thilaksaiK/Automatic_Hydroponics_V2/README.md

Automatic_Hydroponics_V2
==========================
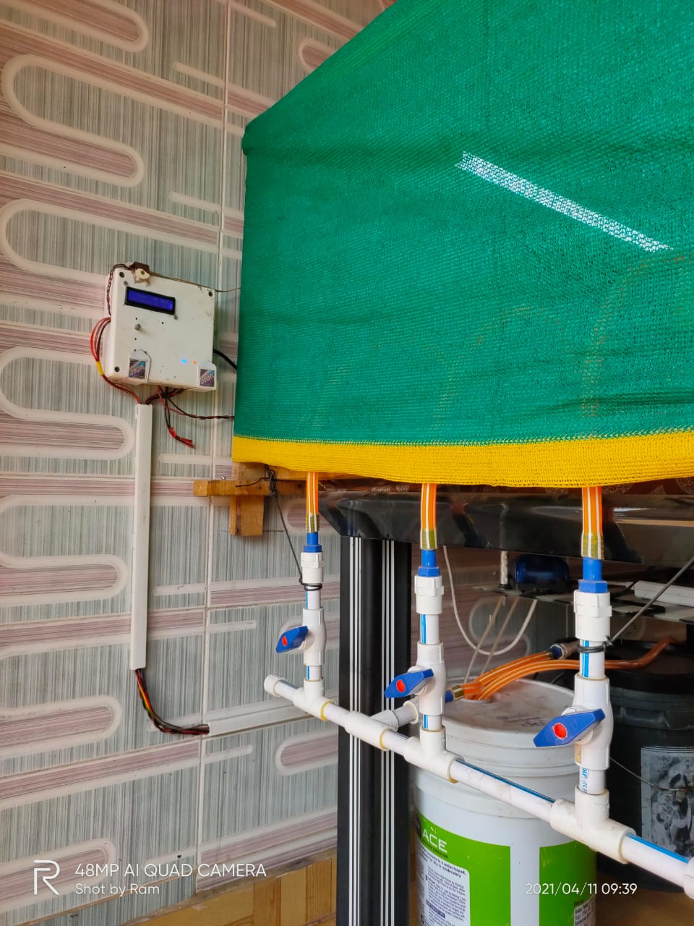
[picture p1: Images/Mounted_Setup.jpeg]
The setup

# The schematic diagram
The Schematic and PCB designs are made using KiCAD. Find the files here: [KiCad_PCB_design](PCB_designes/KiCad_PCB_design/)
## The Schematic Diagram of Master board
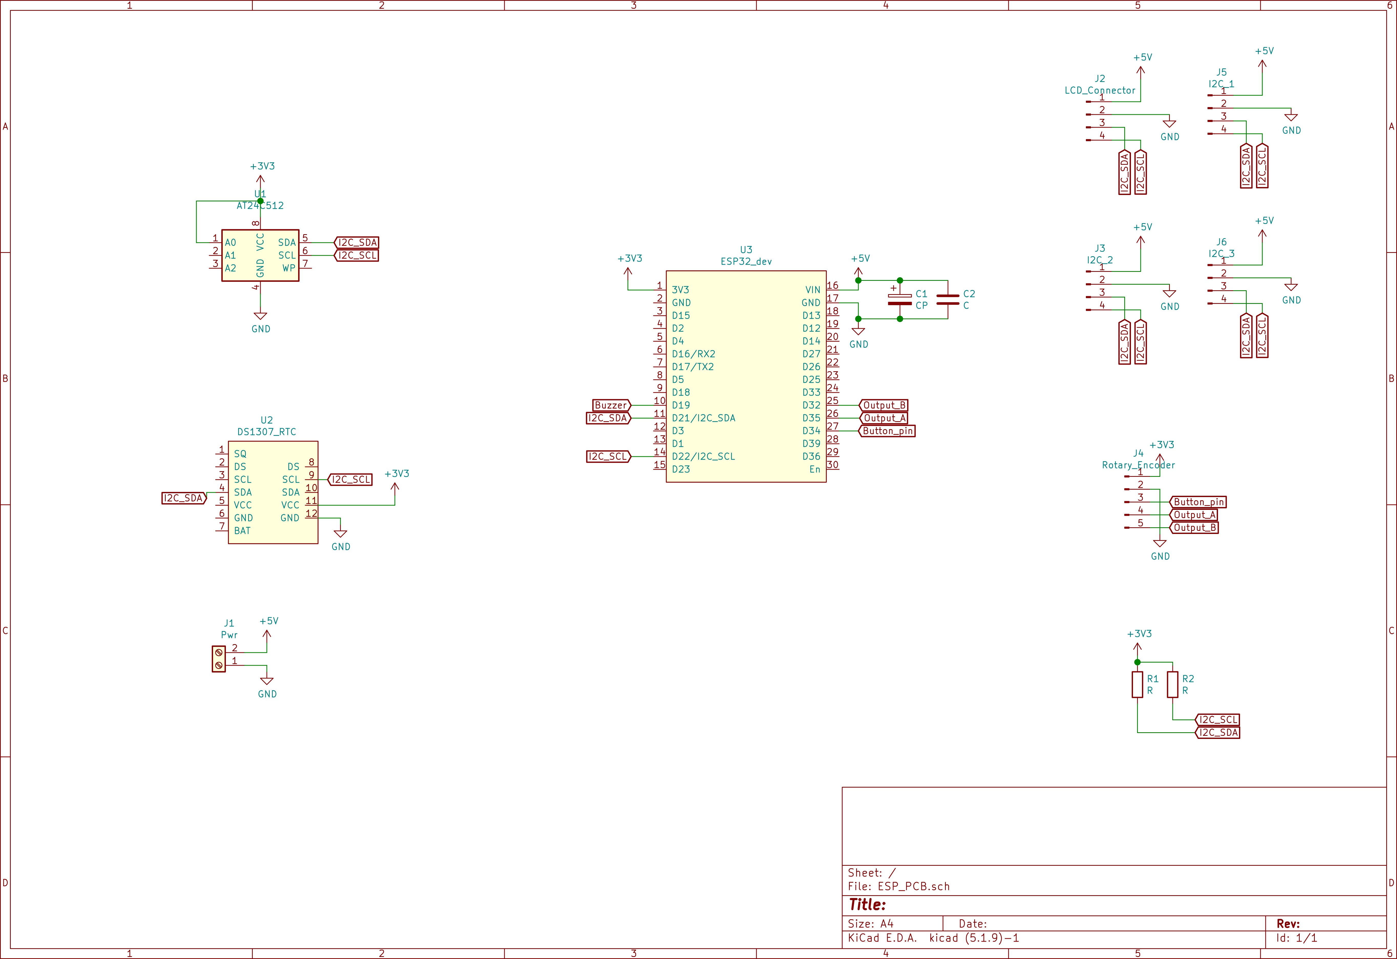
[picture p2: Images/ESP_PCB.jpg]

* The Master board has an ESP32, DS1307 RTC clock, AT24C512 EEPROM and an I2C LCD display.
* The Master board has a JST connecter port to connect to slave board. 

## The Schematic of Slave Board
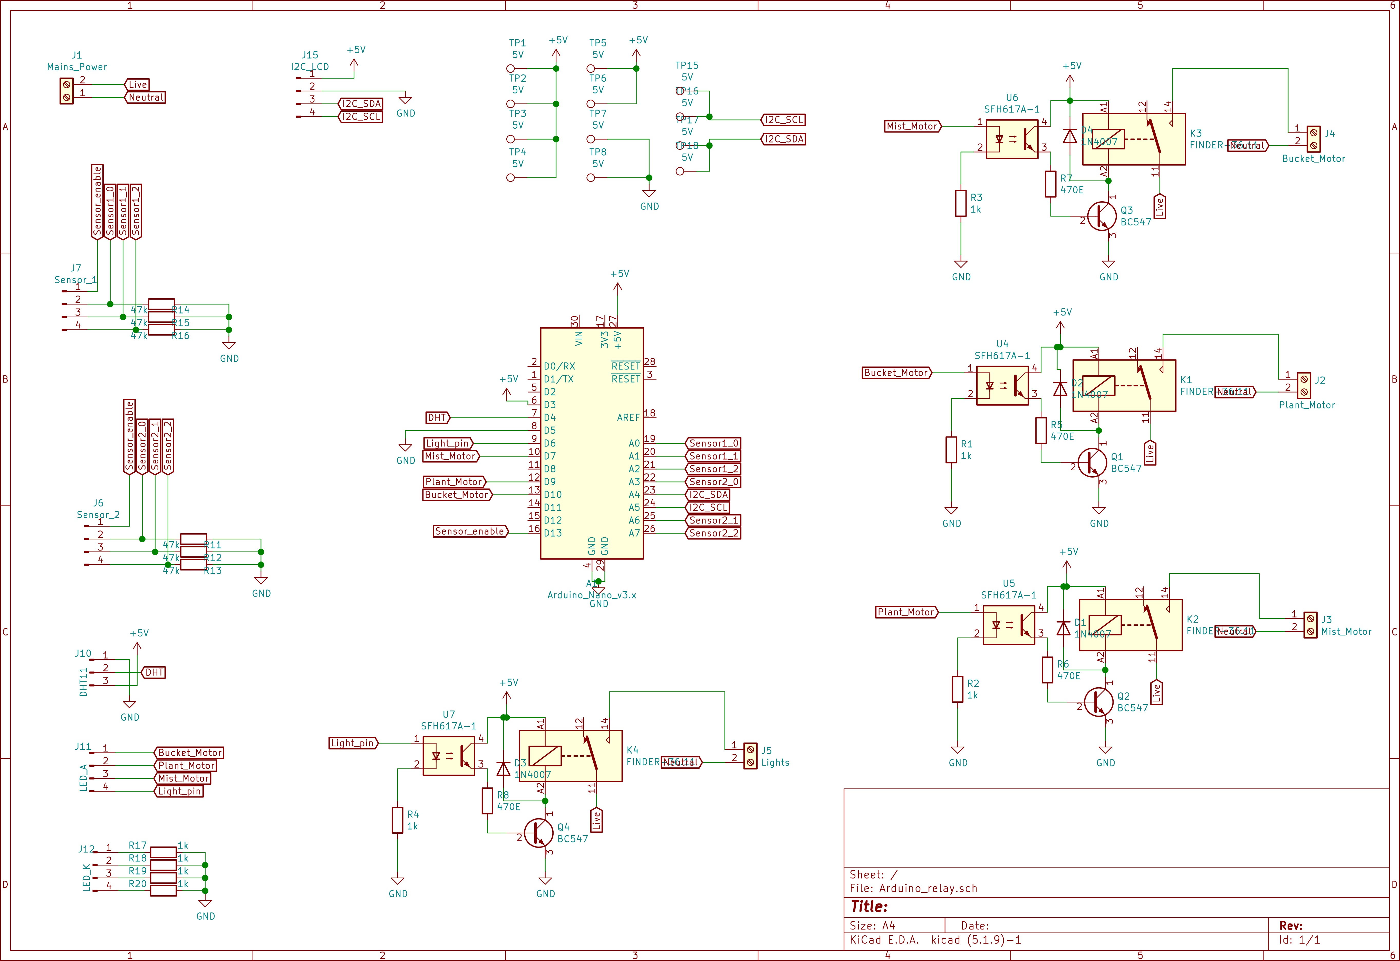
[picture p3: Images/Arduino_relay.jpg]

* The slave board has an Arduino Nano, DHT11 sensor, 4 relays. 
* The master board and slave board are connected with I2C bus.

# PCB Layout
## The PCB Layout of Master board
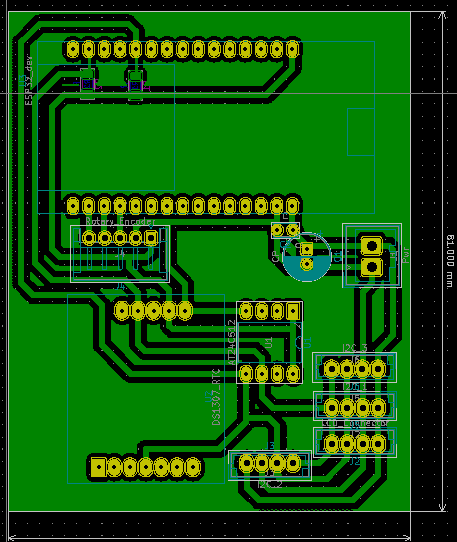
[picture p4: Images/ESP_PCB.png]
Setup_pic.jpg)

## The PCB Layout of Master board
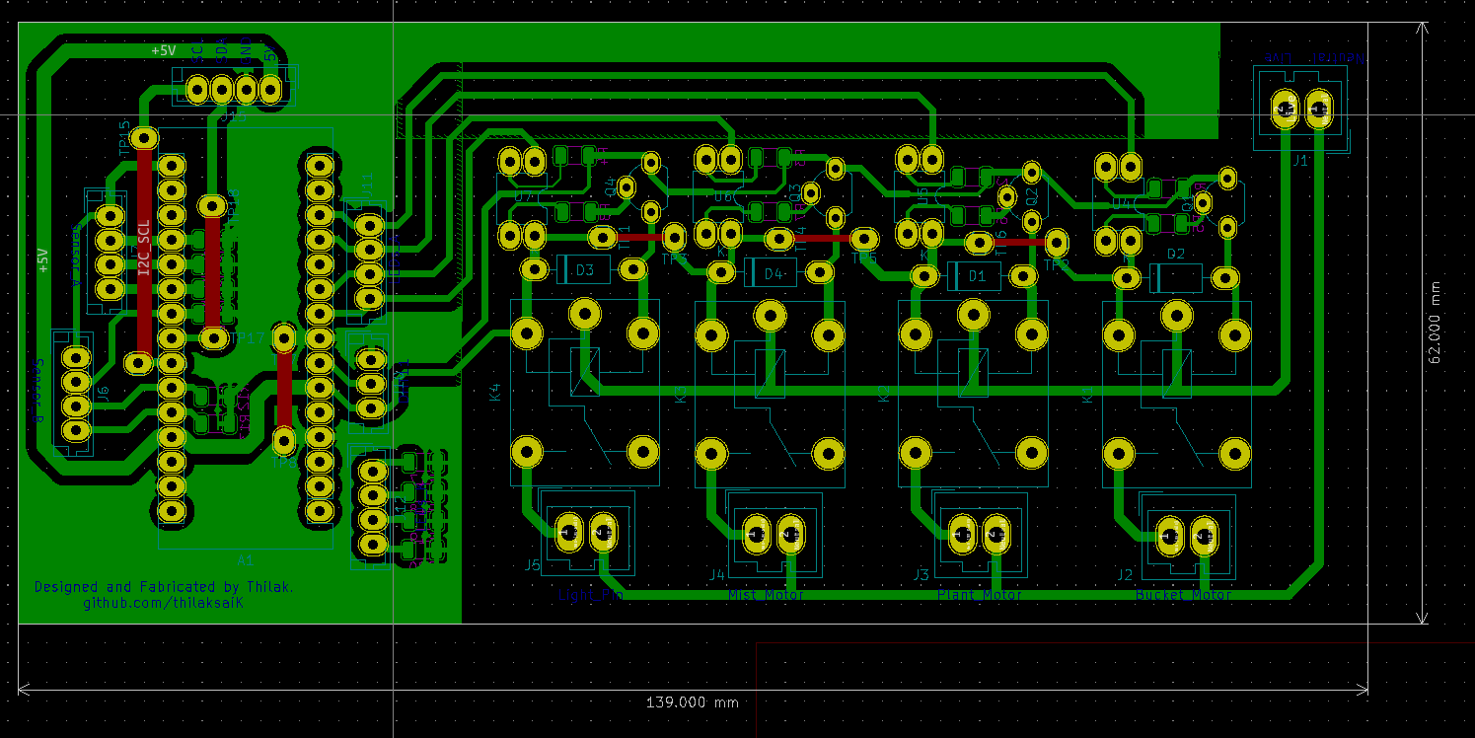
[picture p5: Images/Slave_PCB.png]


# Building the Hardware
## Master board
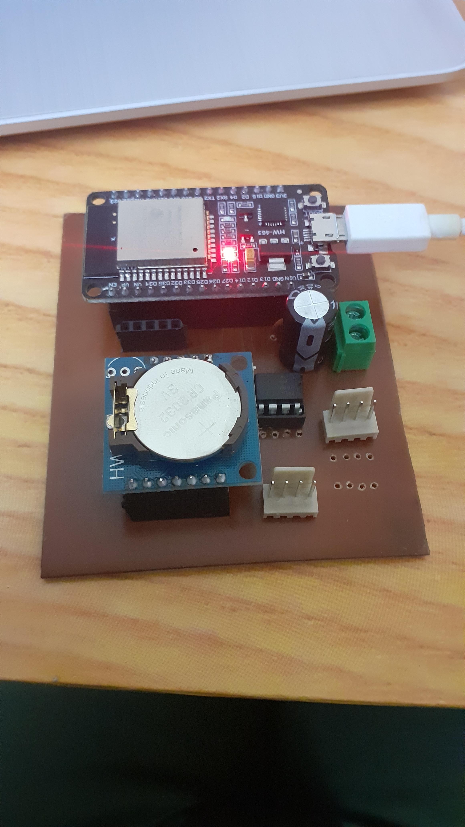
[picture p6: Images/ESP_PCB_pic.jpg]


## Total Setup Overview
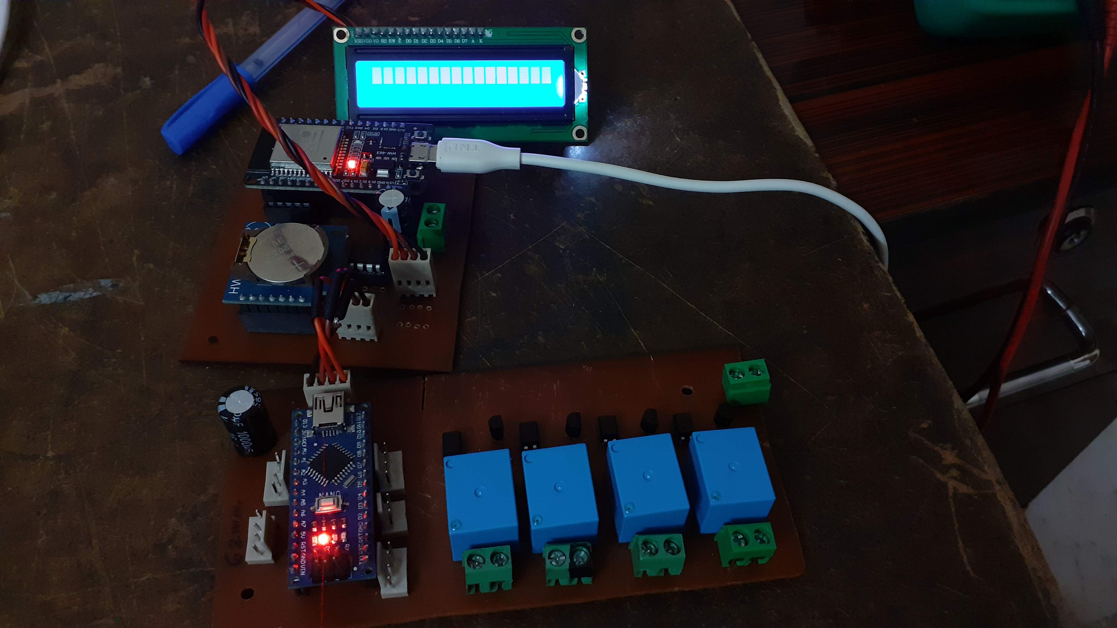
[picture p7: Images/Setup_pic.jpg]


>Find more pictures in [Images](Images) folder
## Using `I2CSB` library.

This Arduino compatible library is made to simplify the communication paradigm that happens between master *ESP32* and slave *Arduino Nano*.

> I2CSB stands for I2C Slave board

The slave arduino nano does the following:
- controls 4 relays named as

1. Bucket Motor connected to pin 10
2. Plant Motor  connected to pin 9
3. Mist Motor   connected to pin 7
4. Light Pin    connected to pin 6

- Is connected to a DHT11 Temperature and Humidity sensor on pin 4.
- Has two set of water level sensors and each water level sensor can detect 3 distinct points in the used buckets.

 You can fetch the slave code here [Arduino_slave.ino](Arduino_sketches/Library/Arduino_I2C_slave/Arduino_I2C_slave.ino)
 
The Master ESP32 can access these function using the `I2CSB` Library. As the name suggests the communication happens in I2C protocol. 

## How to add the library?

To use the library just navigate to [I2CSB](Arduino_sketches/Library/I2CSB/) and download it as zip file. Later in arduino IDE add this library using library manager and get started with the library using examples.

## How to use the functions in the library?

1. First instantiate the class I2CSB with a slave address
```cpp
#define Slave_address 0x2F
I2CSB DB1(Slave_address);
```
2. Initialize the I2C communication by calling `Wire.begin()`

3. The library has following functions

| Function name | What is returned | return type | Arguments |
|---|---|---|---|
| 1. isConnected() |true if slave is connected | bool| no arguments|
| 2. getLevel() |Level encoded in single byte| byte| no arguments|
| 3. getTemperature() |Temperature | int  | no arguments|
| 4. getHumidity() |Humidity | int  | no arguments|
| 5. setOutputs() |`True` if the outputs are set correctly `False` if fails to set| bool | 4 bool variables|

## Handelling the Errors and Miscommunication

The library also can monitor communication error or Miscommunication took place. This is how:

1. For `isConnected()` function the master sends a request to get water level. If there is no error in the received information then the function returns `True`. In the event of death of slave or the slave is not connected or there is a communication error the function returns `False`.
2. For `getLevel()` function the return type is byte and the encoded level information in the byte is as follows `x LA2 LA1 LA0 0 LB2 LB2 LB0` Here LA2,1,0 are points in sensor A and LB2,1,0 are points in Level B sensor. The `x` bit carries the error information. If there is no error in the communication then `x = 1 ` else `x = 0`.
3. For `getTemperature()` function thenreturn type is integer. And the DHT11 sensor can measure the temperatures between 0 to 60degC with a resolution of 1degC. So the information we get out of the sensor can never hit negative temperature. So the function returns -10 if there is any error and returns value between 0 and 60 if there is no error.
4. Similarly for `getHumidity()` function, the return type is int and has values between 20 to 80. so if there is any error then the returned value will be -10.
5. For setOutputs() the return value is `True` if there is no error in communication as well as the outputs are set as expected. 
 The arguments in `setOutputs()` function is in this order `setOutputs(BucketMotor, PlantMotor, MistMotor, LightPin)`
 
 ## The commuication definition.
 
 * The communication is built on I2C protocol.
 * The master sends a byte contains the function the slave has to performs along with the arguments encoded in the single byte.
 * The master requests the slave 200 milliseconds later to send the fetched data/ performed action feedback encoded in 3 bytes as follows.

| Function name | Sent Byte | Received  bytes |
|---|---|---|
| 2. getLevel() | 0xAA | 0xAA 0xYY 0xYY  |
| 3. getTemperature() | 0xCA | 0xCA 0xYY 0xYY  |
| 4. getHumidity() | 0x5c | 0x5C 0xYY 0xYY  |
| 5. setOutputs() | 0x60 | 0x60 0xYY 0xYY  |
| 1. isConnected() | 0xAA | 0xAA 0xYY 0xYY  |

* The first byte is the data that is sent by master to slave so that the master can verify that slave performed correct action. and there was no miscommunication happened. 
* The second two bytes are identical. If they match then the master decides that the information received is correct and and proceeds to decode the bytes.
* The `isConnected()` function is same as `getLevel()` function with a different data type. Because I was ~lazy~ to write a new function for that purpose. 
* The example code can be found here [Example_code.ino](Arduino_sketches/Library/I2CSB/Examples/Example_code/Example_code.ino).

This library can be used as a base to make any type of simple arduino I2C slave device.

# Using EEPROM Database

Find the database library here [DataBase](Arduino_sketches/Library/DataBase/).

The data structure:
* The following data is stored in EEPROM Every minute.

| Data | Bytes taken | Range |
|---|---|---|
|Day, Hour, Minute in the month| 2 bytes | 44640|
|Temperature | 1 byte | 0 to 60 degC|
|Humidity | 1 byte | 20 to 80% |
|Level Array| 1 byte| 0x00 to 0x77|

* In a nutshell each data set consumes 5 bytes so the EEPROM can log the data for complete 9 days.
* The pointer of next address to be written locally on EEPROM because if arduino restarts the local pointer on arduino will be lost and the new data is re-written on EEPROM.
* The EEPROM used here is *AT24C512* which can store 512Kbits or 64KBytes which are byte addressable. So the address value renge is from 0x0000 to 0xFFFF which is exactly same size that an integer(2 bytes) takes in an Arduino.
* Therefore the first two bytes in the EEPROM is reserved to write the address pointer.
* The following table represents the data structure employed.

| Address | Data |
|---|---|
| 0 , 1 | Address pointer|
| 2 - 6 | Data set 1|
| 7 - 11| Data set 2|
| 12 - 16 | Data set 3|
|(5n-3) - (5n+1) | Data set n|

## Functions

The library offers following functions:

|Function name | arguments | return value|
|---|---|---|
|[storeAt](https://github.com/thilaksaiK/Automatic_Hydroponics_V2/blob/main/README.md#storeat)|EEPROM Object, Address, Day, Hour, Minute, Temperature, Humidity, Waterlevel array| void type|
|[resetAddress](https://github.com/thilaksaiK/Automatic_Hydroponics_V2/blob/main/README.md#resetAddress)|EEPROM Object|void|
|[getDataAt](https://github.com/thilaksaiK/Automatic_Hydroponics_V2/blob/main/README.md#getDataAt)| EEPROM Object, Address, Data-literal| Data|
|[getNextAddress](https://github.com/thilaksaiK/Automatic_Hydroponics_V2/blob/main/README.md#getNextAddress)| EEPROM Object| Address of next Dataset to be written|
|[resetAddress](https://github.com/thilaksaiK/Automatic_Hydroponics_V2/blob/main/README.md#resetAddress)| EEPROM Object| resets the address pointer to initial value|
### Usage
* Include the library DataBase and [I2CEEPROM](https://github.com/RobTillaart/Arduino/tree/master/libraries/I2C_EEPROM) on arduino IDE.
* create an I2C_eeprom object
```c++
I2C_eeprom ee(0x50, I2C_DEVICESIZE_24LC512);
```
* Create a DataBase object
```c++
DataBase DB;
```
* Begin the EEPROM object ``` ee ``` using ``` ee.begin()```.
* Use the APIs in database.h file.
