thilaksaiK/Automatic_Hydroponics_V2/Images/CloseUp_Mounted.jpeg

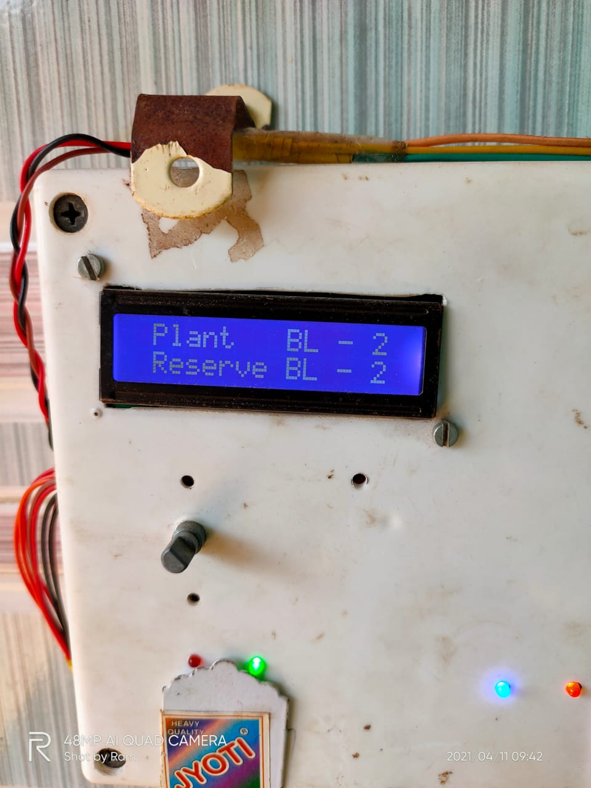
Images/CloseUp_Mounted.jpeg
