thilaksaiK/Automatic_Hydroponics_V2/Images/Assembled_Enclosure.jpeg

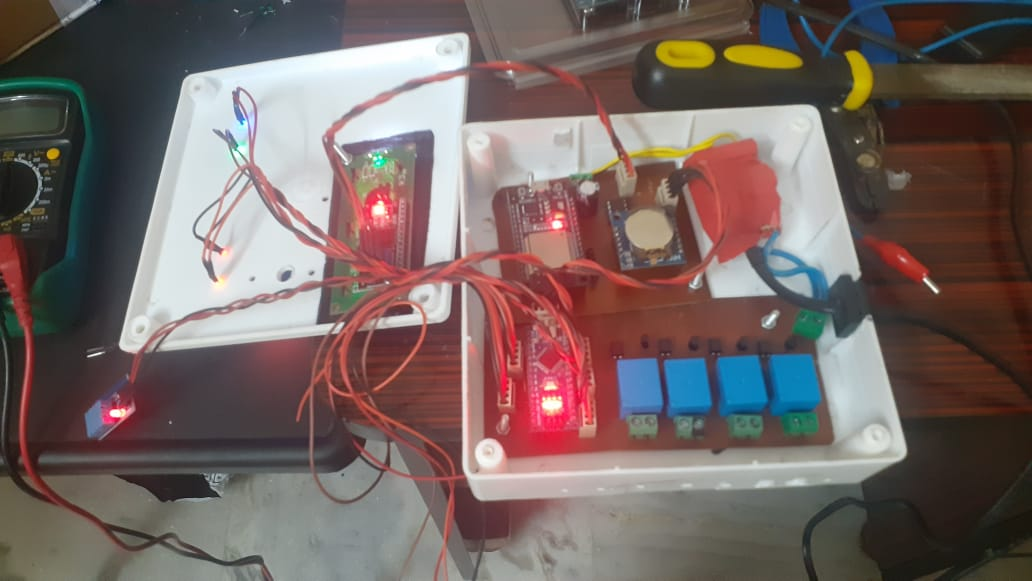
Images/Assembled_Enclosure.jpeg
