thilaksaiK/Automatic_Hydroponics_V2/Images/TotalSetup_Img.jpeg

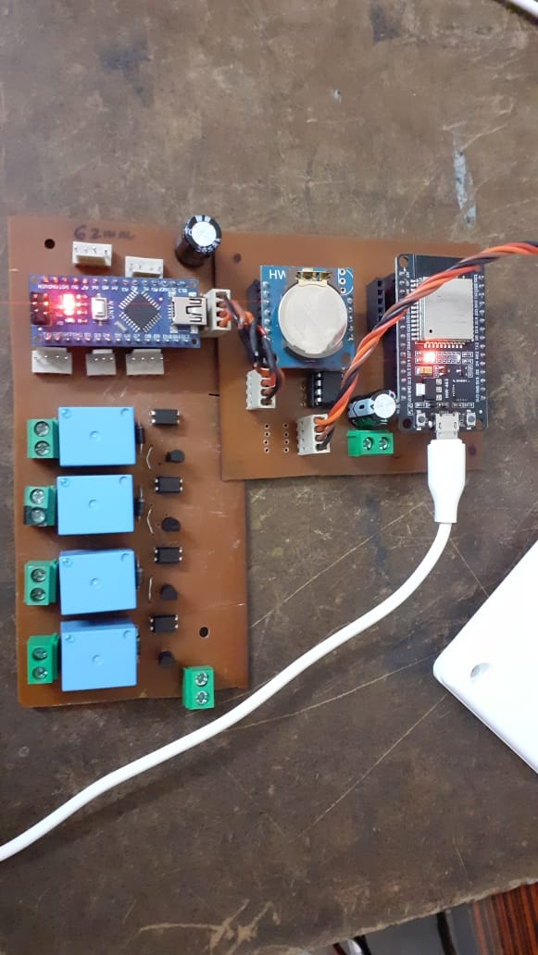
Images/TotalSetup_Img.jpeg
