thilaksaiK/Automatic_Hydroponics_V2/(commit log)

2021-02-26 Initialized the broken repo
    [Arduino_relay.kicad_pcb, Arduino_relay.sch, ESP_PCB.kicad_pcb, ESP_PCB.sch]
2021-02-27 Added Images
    [Arduino_relay.kicad_pcb, Arduino_relay.sch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]
2021-03-11 modified the arduino slave code
